roberben/Mixer32/IMAGES/esquemaElectrico.png

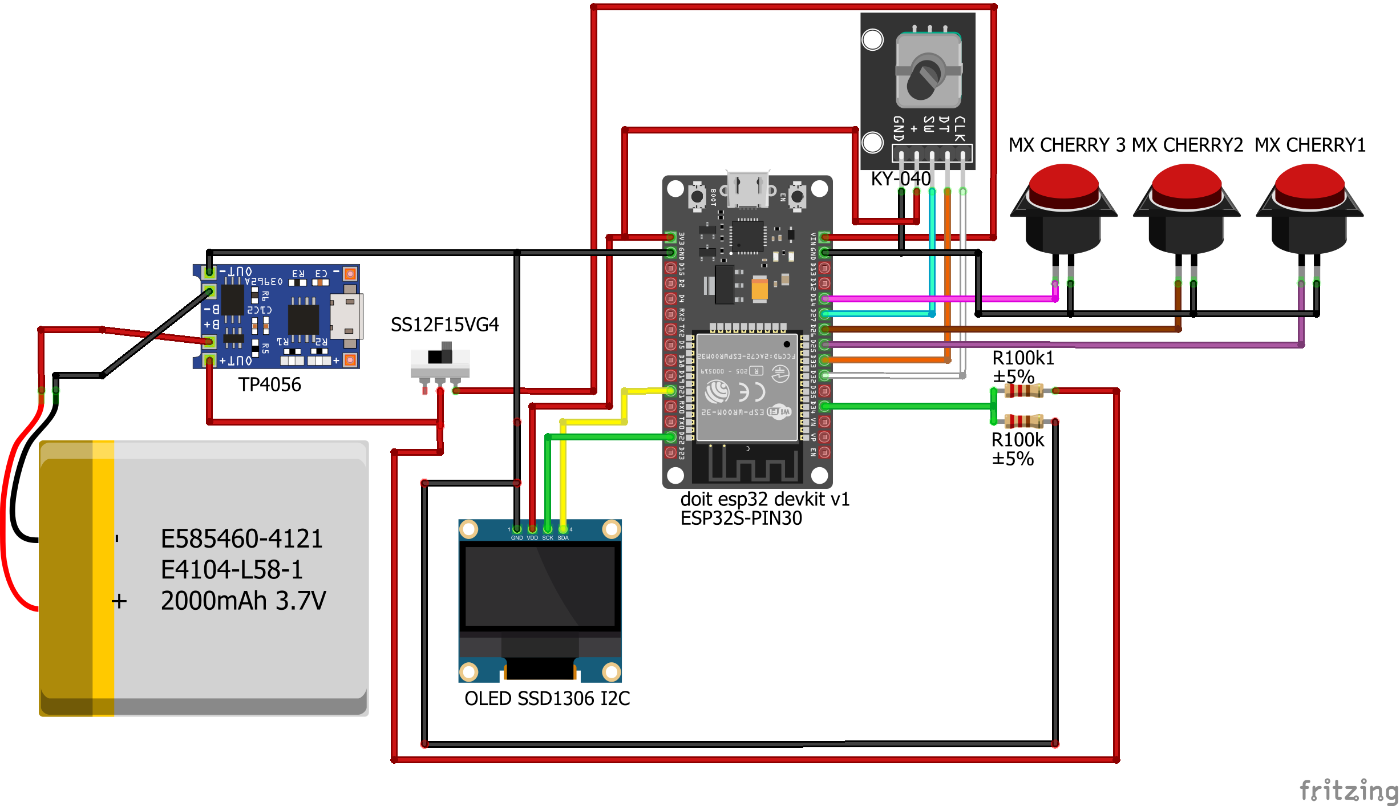
IMAGES/esquemaElectrico.png
