roberben/Mixer32/(commit log)

2026-05-16 Agregar archivos de proyecto.
2026-05-18 Materiales DIY
2026-05-18 Código arduino para el periférico.
2026-05-18 Update wiring section with new diagram
    Updated wiring diagram and added new image reference.
2026-05-19 Revise wiring connections and battery status section
    Updated wiring diagram and references in README.
2026-05-19 Update installation instructions for Arduino IDE
2026-05-20 Revise README for PlatformIO usage and Arduino IDE removal
    Updated instructions for compiling the project with PlatformIO and removed support for Arduino IDE.
2026-05-20 Añadido instalador web de firmware en carpeta docs
2026-05-20 Añadido código fuente de PlatformIO al repositorio
